DavideNesi/diabot/README.md

# Diabot
## A DIY telepresence robot

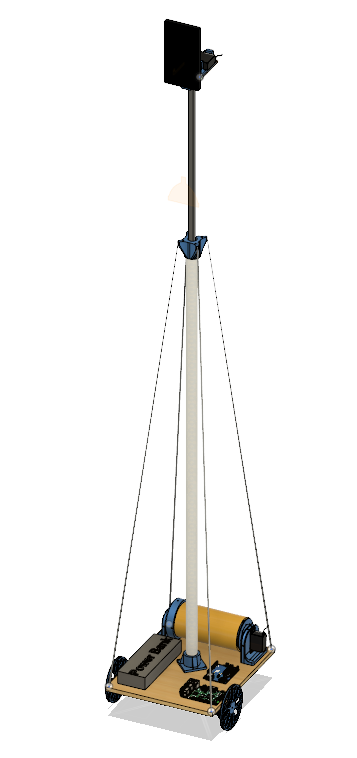
[picture p1: model.png]
Diabot
