DavideNesi/diabot/code/WebInterface/gc1.png

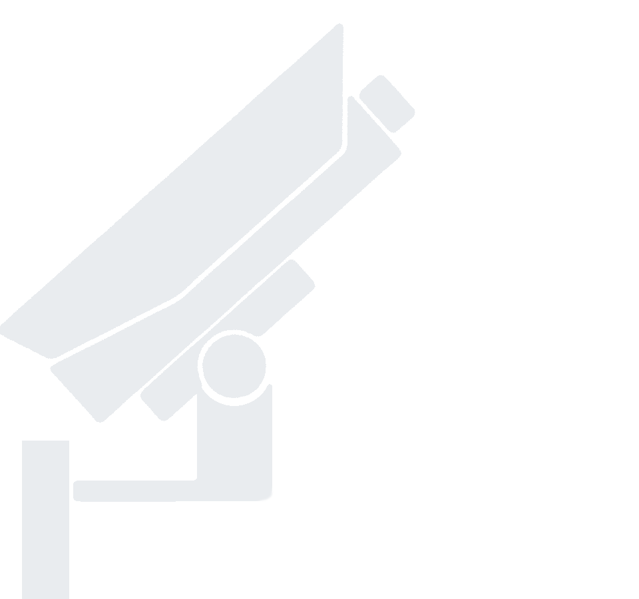
code/WebInterface/gc1.png
