DavideNesi/diabot/code/WebInterface/gc2.png

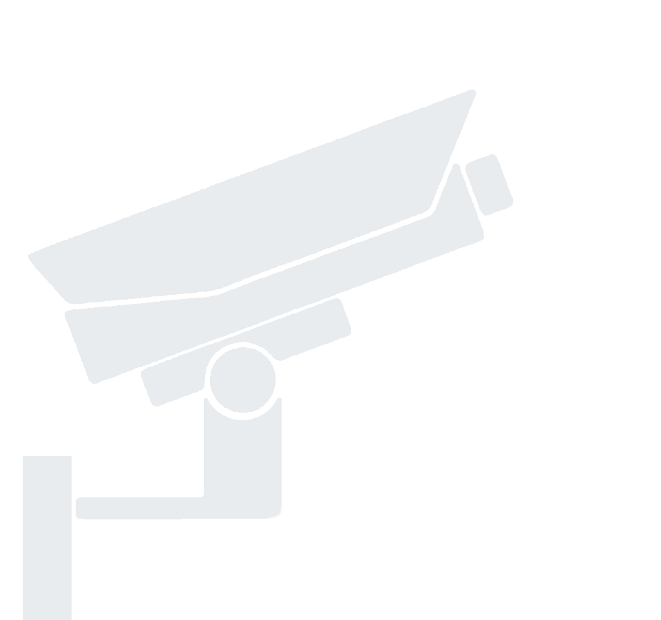
code/WebInterface/gc2.png
