DavideNesi/diabot/code/WebInterface/gc3.png

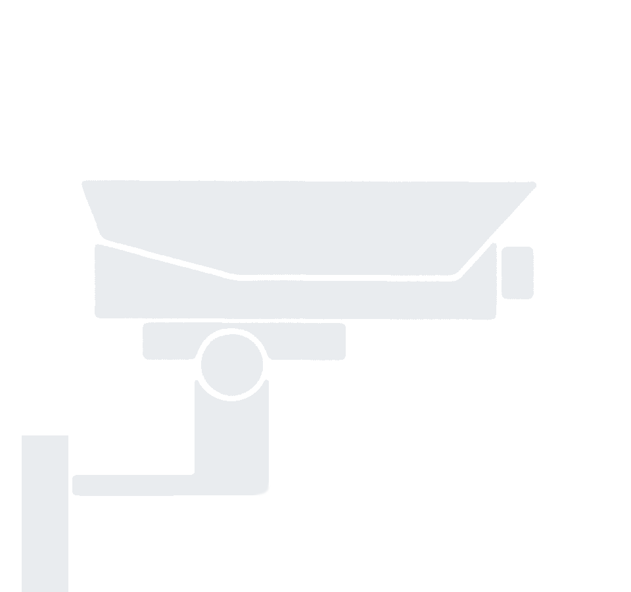
code/WebInterface/gc3.png
