DavideNesi/diabot/code/WebInterface/gc4.png

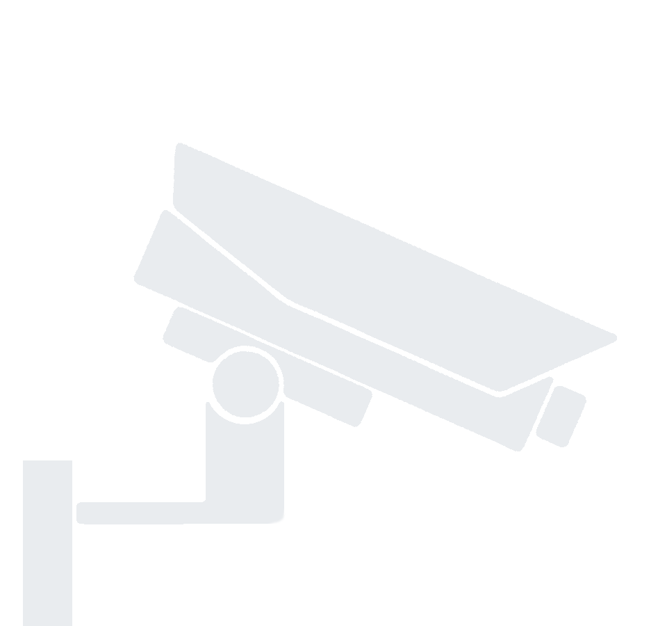
code/WebInterface/gc4.png
