DavideNesi/diabot/code/WebInterface/gc5.png

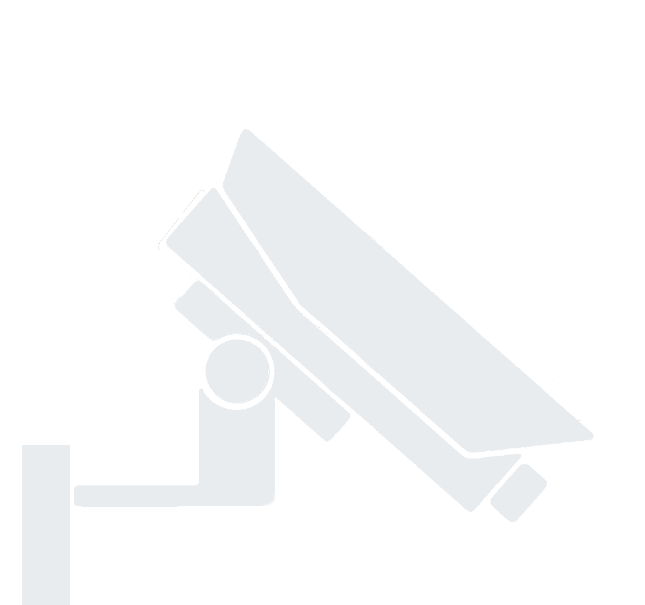
code/WebInterface/gc5.png
