DavideNesi/diabot/code/WebInterface/stub.png

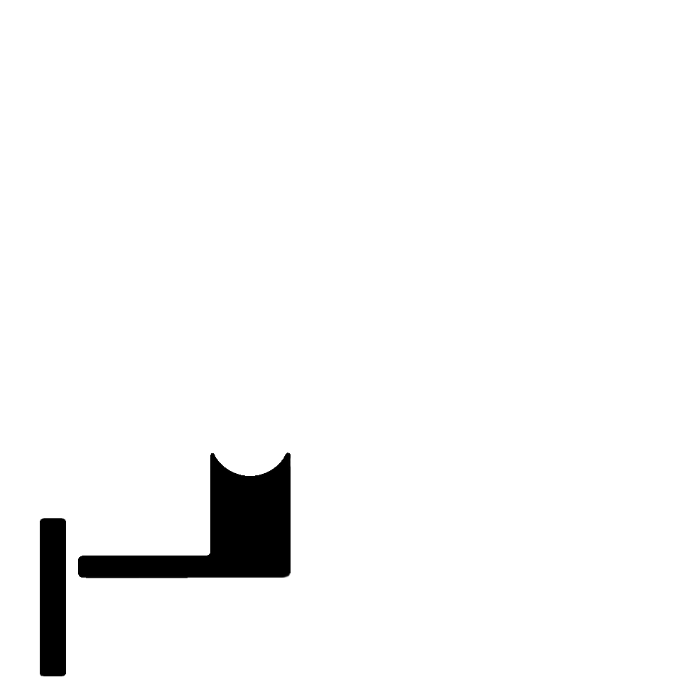
code/WebInterface/stub.png
