DavideNesi/diabot/3d prints/head/DiaBotHeadMount.stl

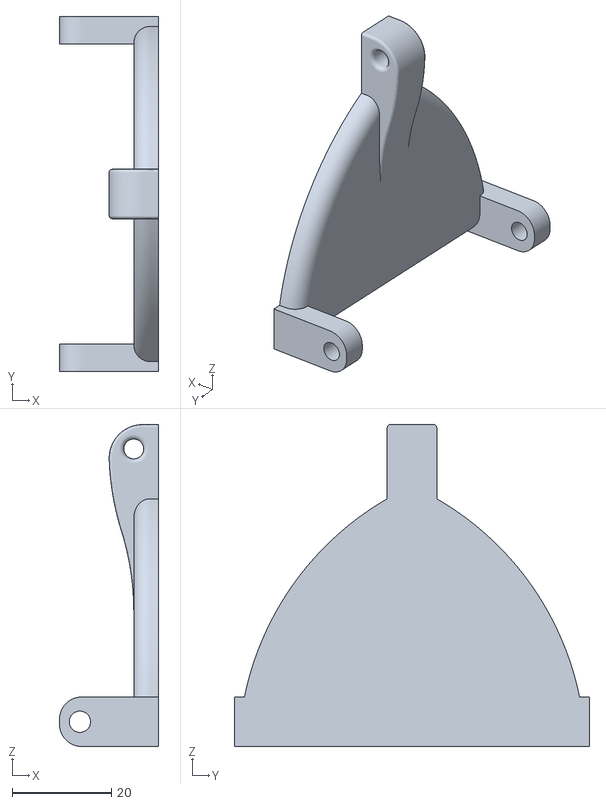
[picture p16: CAD file, 2019-01-07]
3d prints/head/DiaBotHeadMount.stl
20.0 x 71.6 x 65.0
