DavideNesi/diabot/3d prints/poleHolder/squareTubeAdapter.stl

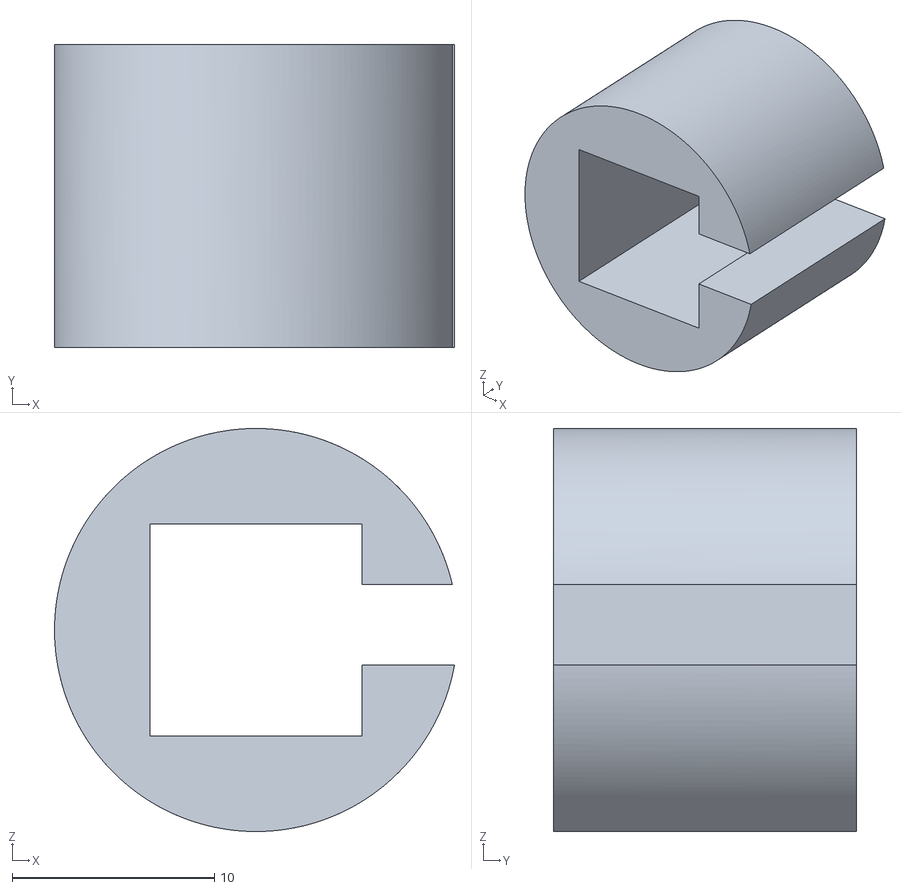
[picture p17: CAD file, 2019-01-07]
3d prints/poleHolder/squareTubeAdapter.stl
19.8 x 15.0 x 20.0
