DavideNesi/diabot/3d prints/wheels/thirdWheel/Ball.stl

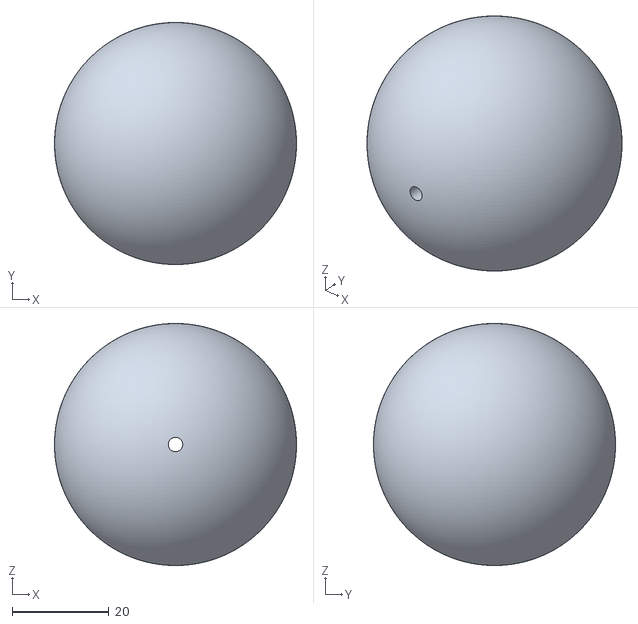
[picture p18: CAD file, 2019-01-07]
3d prints/wheels/thirdWheel/Ball.stl
50.0 x 49.9 x 50.0
