DavideNesi/diabot/3d prints/wheels/WheelDiaBot.stl

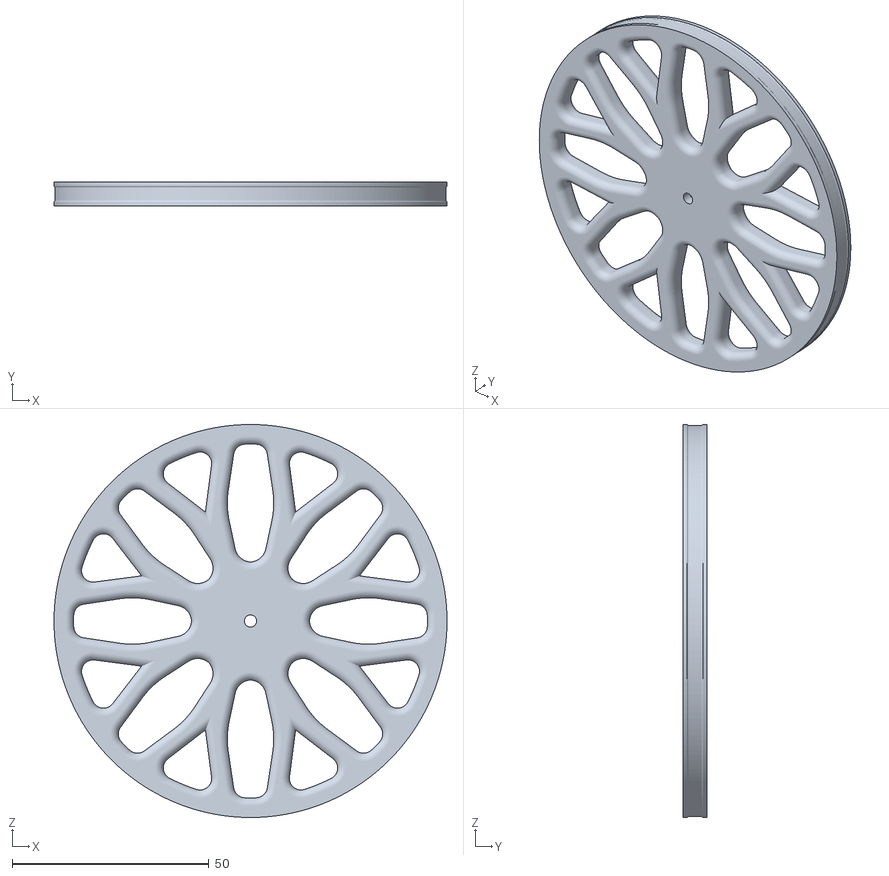
[picture p19: CAD file, 2019-01-07]
3d prints/wheels/WheelDiaBot.stl
100.0 x 6.00 x 100.0
