DavideNesi/diabot/3d prints/acendingAssembly/ServoMotorHolder.stl

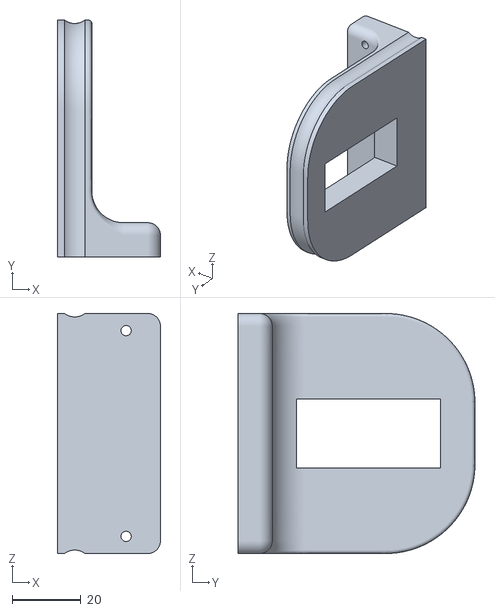
[picture p20: CAD file, 2019-01-07]
3d prints/acendingAssembly/ServoMotorHolder.stl
30.0 x 69.1 x 70.0
