DavideNesi/diabot/3d prints/head/servoHorn.stl

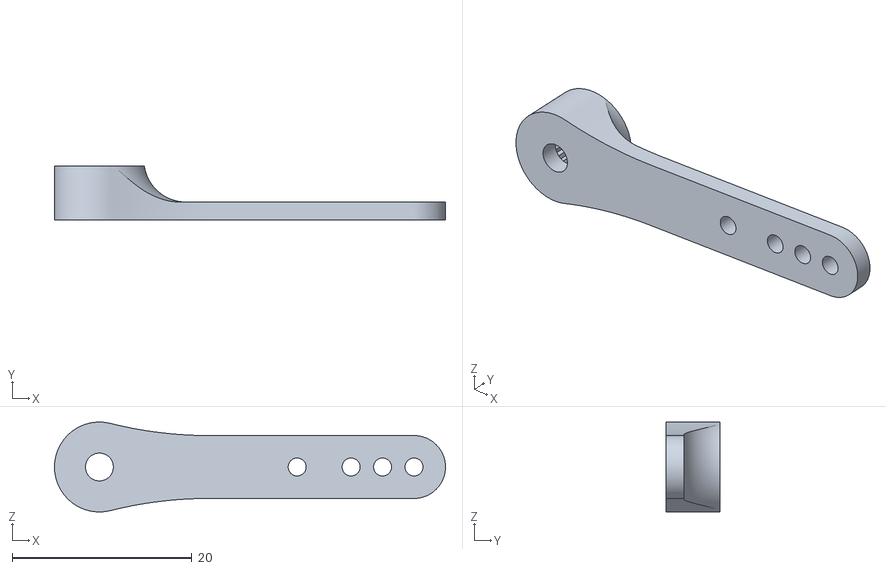
[picture p21: CAD file, 2019-01-07]
3d prints/head/servoHorn.stl
43.5 x 6.00 x 10.00
