DavideNesi/diabot/3d prints/poleHolder/PoleTensioner.stl

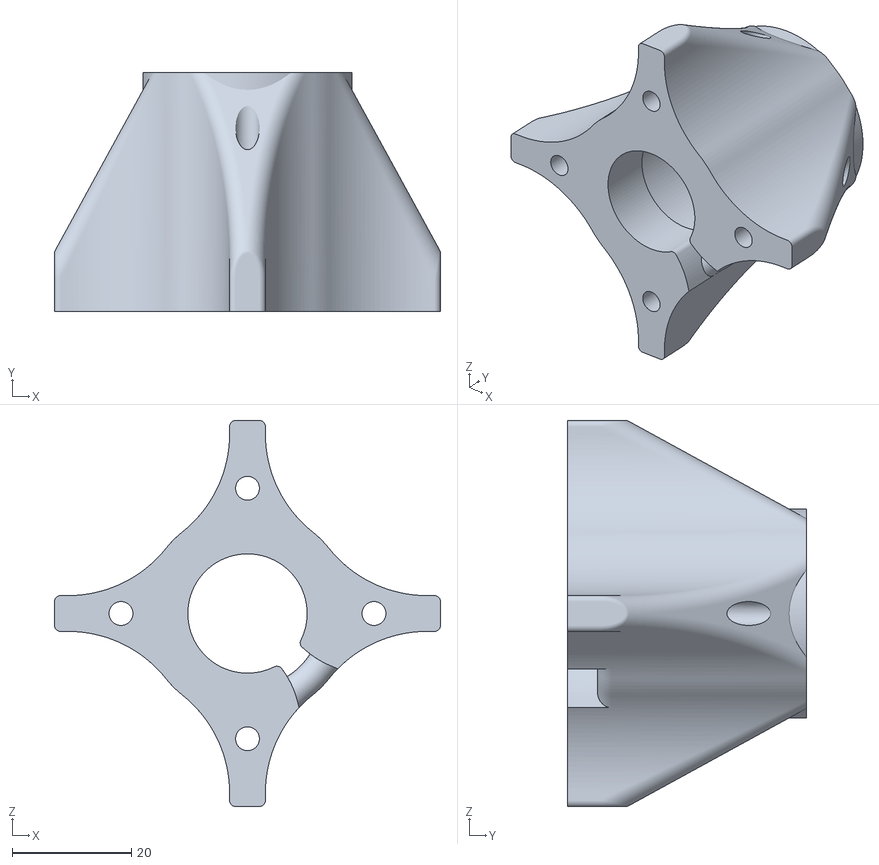
[picture p22: CAD file, 2019-01-07]
3d prints/poleHolder/PoleTensioner.stl
64.7 x 40.0 x 64.7
