DavideNesi/diabot/3d prints/wheels/thirdWheel/BallHolder.stl

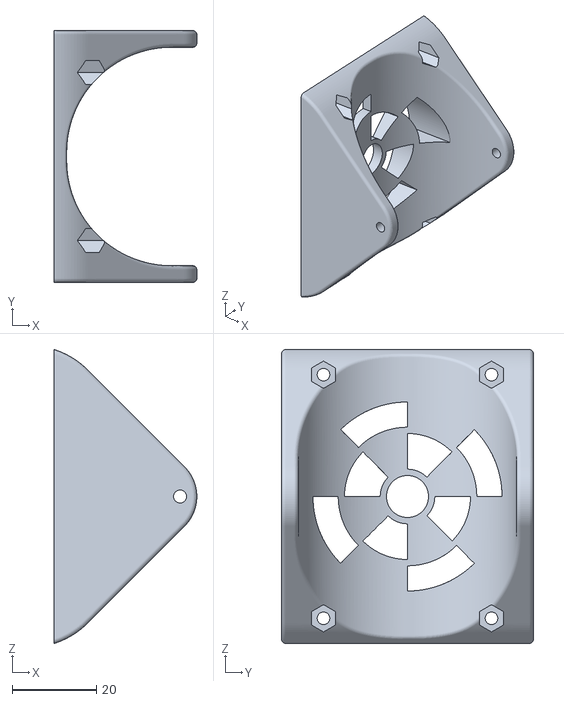
[picture p23: CAD file, 2019-01-07]
3d prints/wheels/thirdWheel/BallHolder.stl
34.0 x 60.0 x 70.0
