DavideNesi/diabot/3d prints/acendingAssembly/ServoTinAdapter.stl

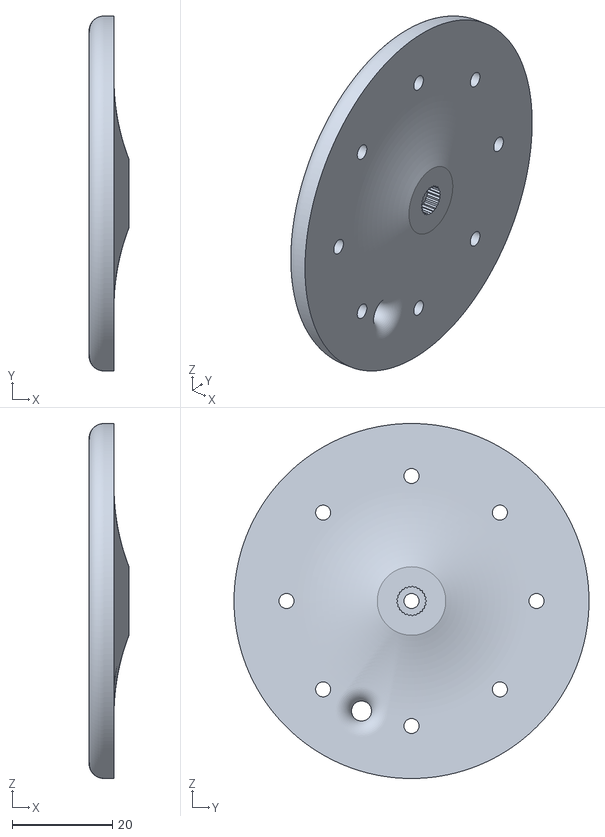
[picture p24: CAD file, 2019-01-07]
3d prints/acendingAssembly/ServoTinAdapter.stl
8.00 x 71.0 x 71.0
