DavideNesi/diabot/3d prints/head/DiaBotNeck.stl

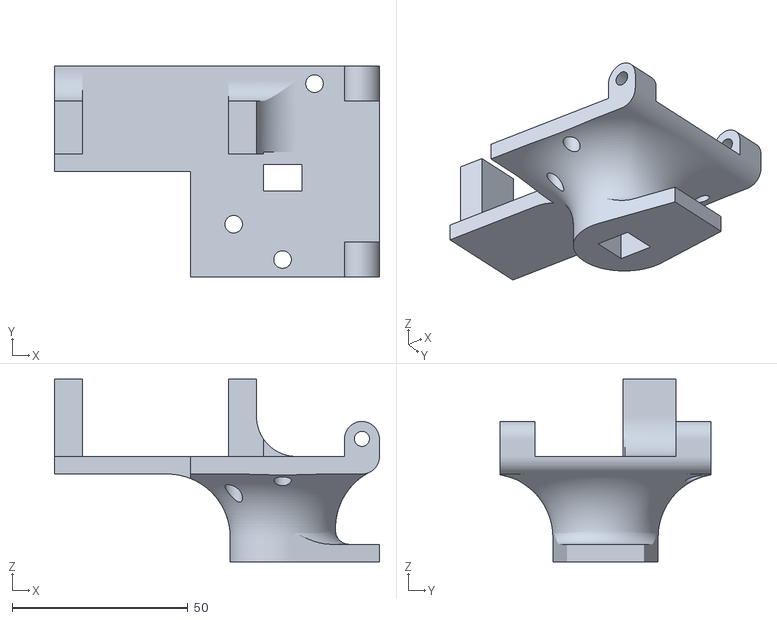
[picture p25: CAD file, 2019-01-07]
3d prints/head/DiaBotNeck.stl
92.5 x 60.0 x 52.0
