DavideNesi/diabot/3d prints/poleHolder/poleHolder.stl

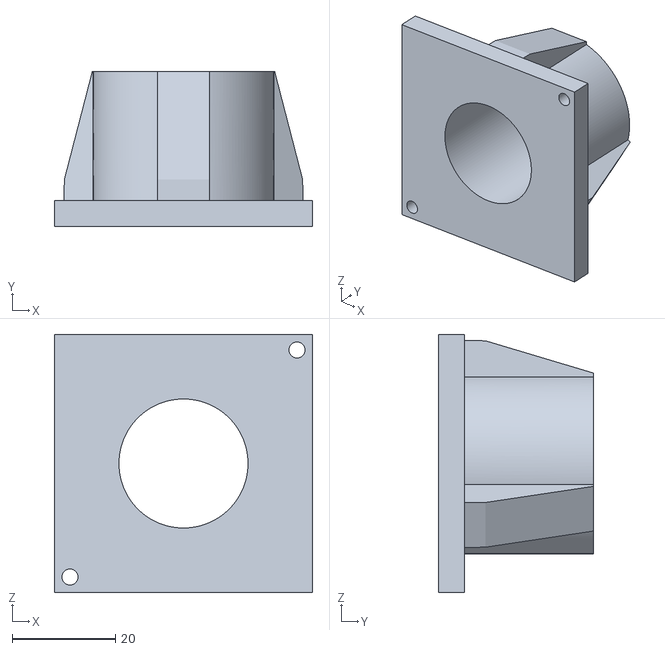
[picture p26: CAD file, 2019-01-07]
3d prints/poleHolder/poleHolder.stl
50.0 x 30.0 x 50.0
