DavideNesi/diabot/3d prints/acendingAssembly/TinScrewAdapter.stl

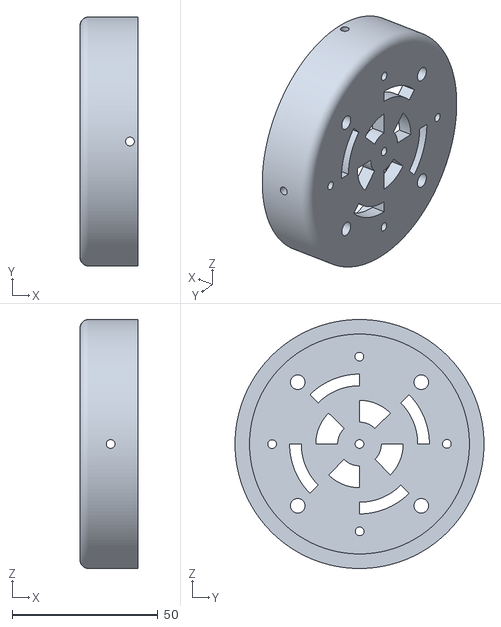
[picture p28: CAD file, 2019-01-07]
3d prints/acendingAssembly/TinScrewAdapter.stl
20.0 x 85.5 x 85.5
